soyFACE/chamberozonecontrol-Rev2/Documentation/wiring diagram/wiring diagram R1.pdf

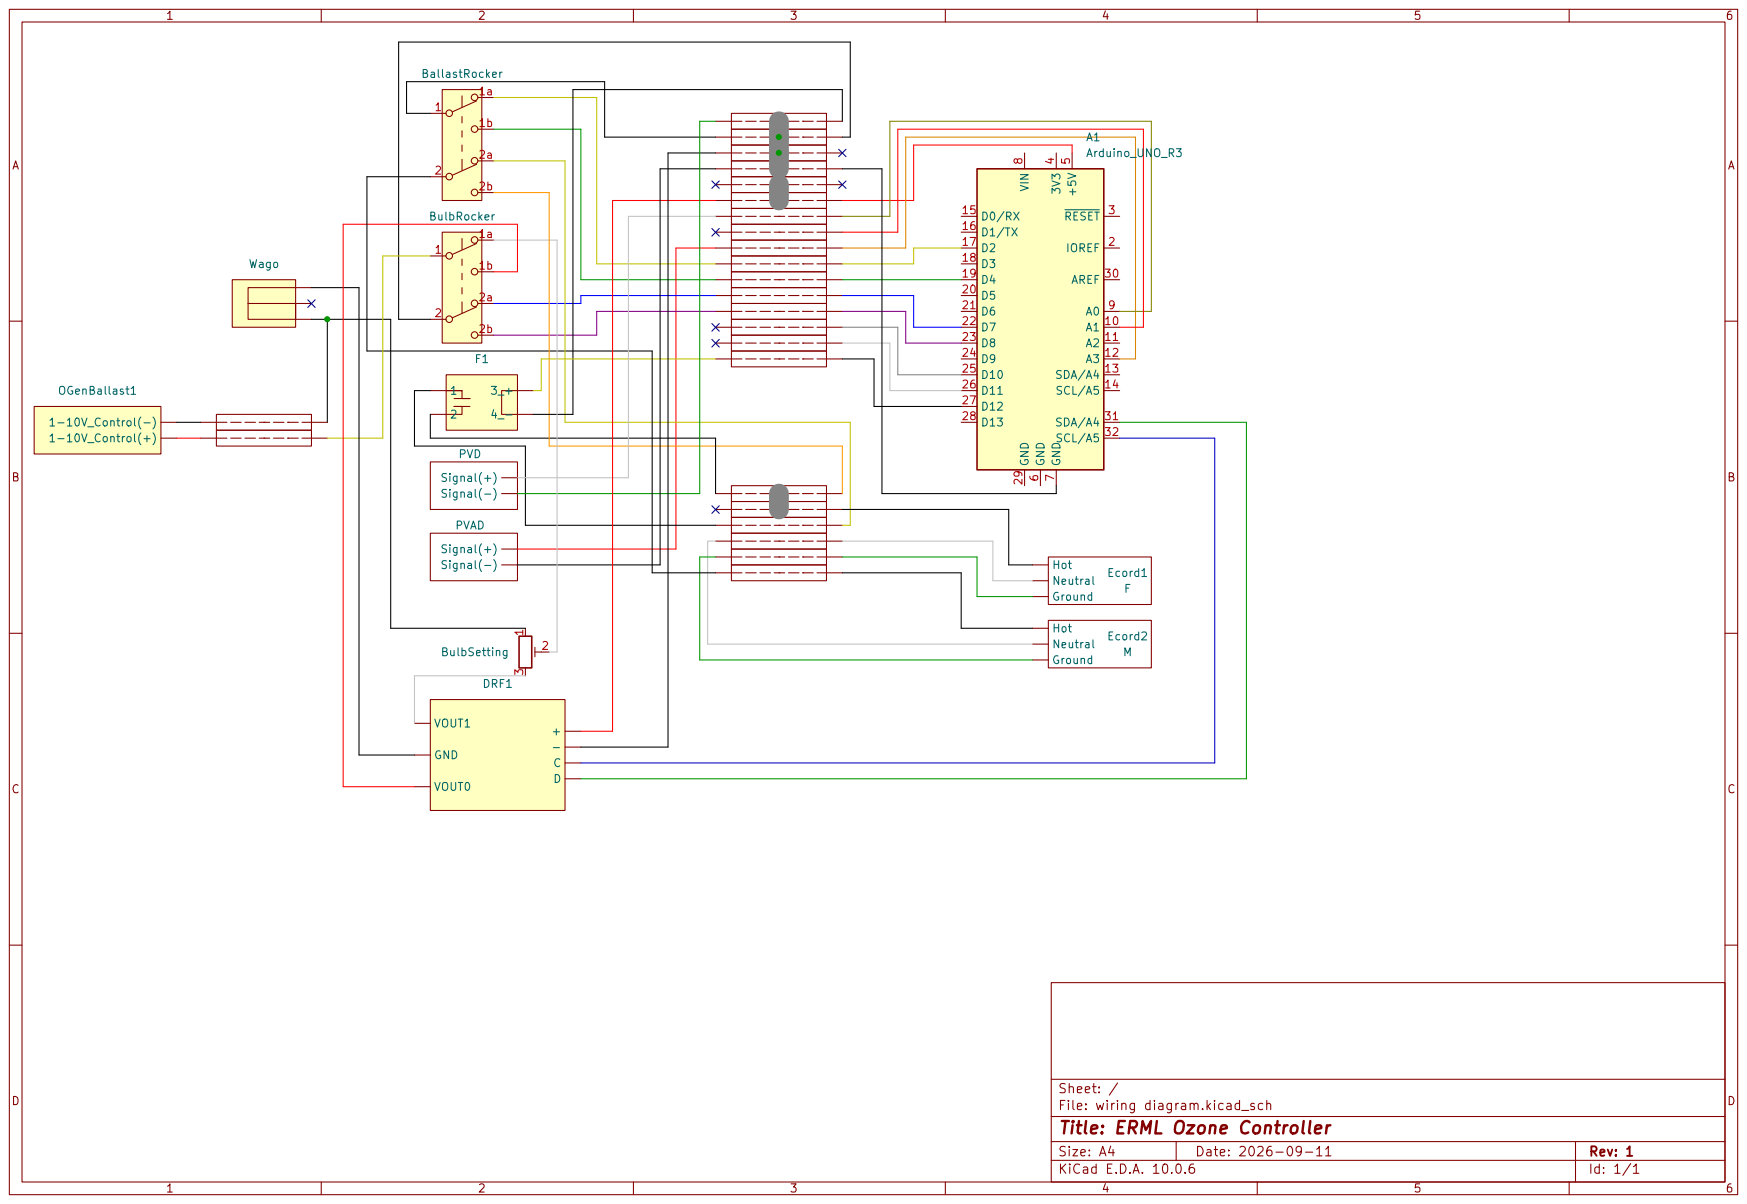
[picture p1: page 1]
