soyFACE/chamberozonecontrol-Rev2/Documentation/wiring diagram/wiring diagram.kicad_sch

## KiCad design Documentation/wiring diagram/wiring diagram.kicad_sch (2026-09-14)

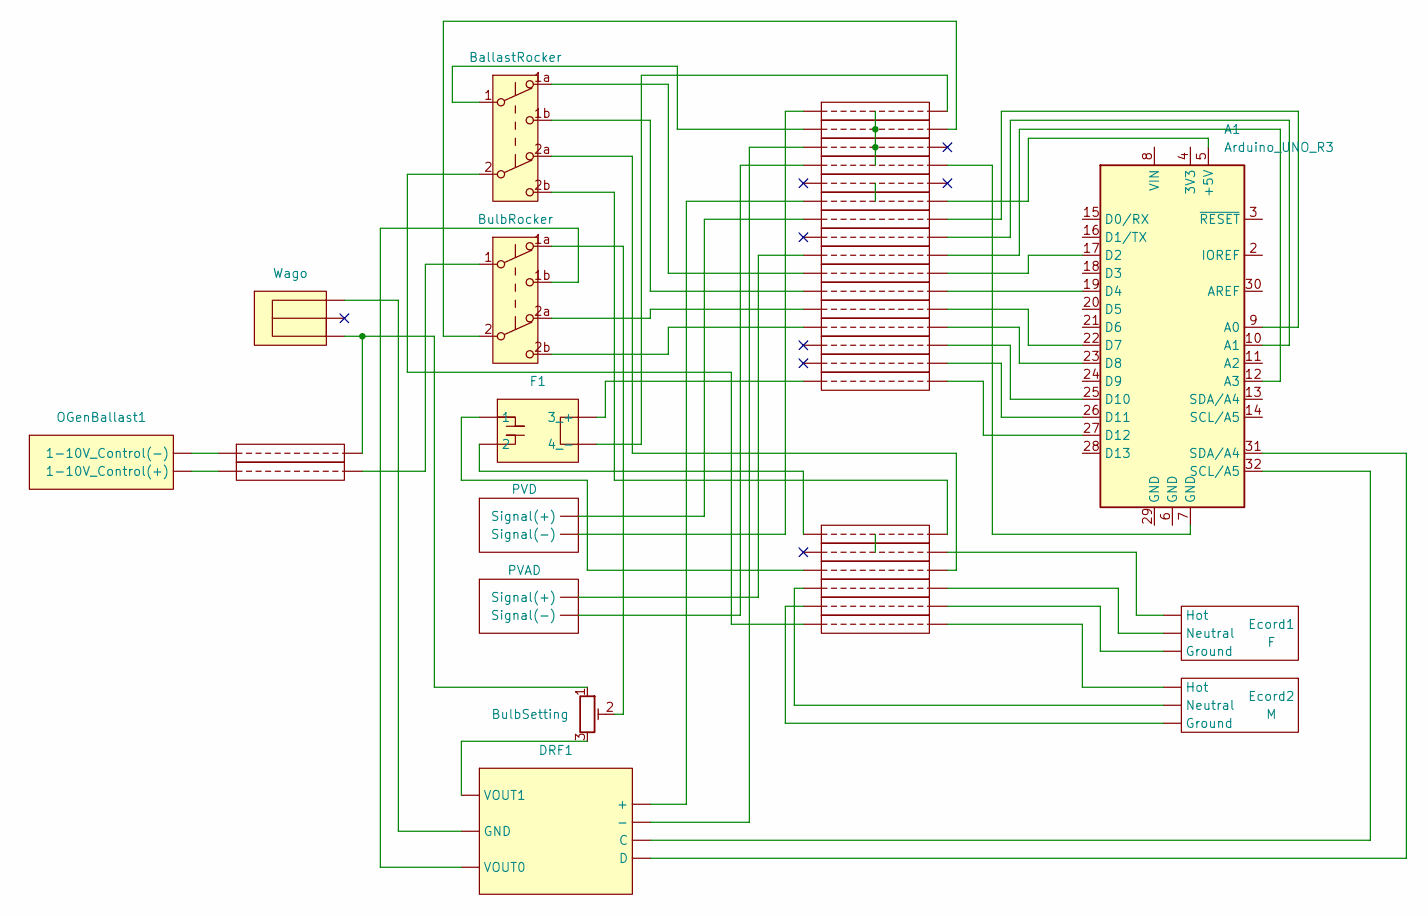
[picture p2: schematic wiring diagram.kicad_sch]

Parts:
A1: Arduino_UNO_R3
BallastRocker: SW_Push_DPDT
BulbRocker: SW_Push_DPDT
BulbSetting: R_Potentiometer_Trim
DRF1: (no value)
Ecord1: F
Ecord2: M
F1: (no value)
OGenBallast1: (no value)
PVAD: O1
PVD: O1
U1: 1
U2, U3, U4, U5, U6, U7, U8, U9, U10, U11, U12, U13, U14, U15, U16, U17, U18, U19, U20, U21, U22, U23, U24: 2
Wago: (no value)

Connections:
unnamed: A1.5 (+5V), U11.
unnamed: A1.7 (GND), U13.
unnamed: A1.9 (A0), U10.
unnamed: A1.10 (A1), U9.
unnamed: A1.12 (A3), U8.
unnamed: A1.17 (D2), U1.
unnamed: A1.19 (D4), U2.
unnamed: A1.22 (D7), U3.
unnamed: A1.23 (D8), U4.
unnamed: A1.25 (D10), U5.
unnamed: A1.26 (D11), U6.
unnamed: A1.27 (D12), U7.
unnamed: A1.31 (SDA/A4), DRF1.
unnamed: A1.32 (SCL/A5), DRF1.
unnamed: BallastRocker.1 (B), U15.
unnamed: BallastRocker.1a (A), U1.
unnamed: BallastRocker.1b (C), U2.
unnamed: BallastRocker.2 (B), U24.
unnamed: BallastRocker.2a (A), U21.
unnamed: BallastRocker.2b (C), U19.
unnamed: BulbRocker.1 (B), U18.
unnamed: BulbRocker.1a (A), BulbSetting.2
unnamed: BulbRocker.1b (C), DRF1.
unnamed: BulbRocker.2 (B), U15.
unnamed: BulbRocker.2a (A), U3.
unnamed: BulbRocker.2b (C), U4.
unnamed: BulbSetting.1, U17., Wago.
unnamed: BulbSetting.3, DRF1.
unnamed: DRF1., U11., U14., Wago.
unnamed: Ecord1., U20., U22., U23.
unnamed: Ecord2., U22., U23., U24.
unnamed: F1., U7., U16., U19., U21.
unnamed: OGenBallast1., U17., U18.
unnamed: PVAD., U8., U13.
unnamed: PVD., U10., U16.
unnamed: U11., U12.
unnamed: U13., U14., U15., U16.
unnamed: U19., U20.
