soyFACE/chamberozonecontrol-Rev2/Documentation/wiring table.xlsx

device A | device A pin | device B pin | device pin | wire color
arduino | 0
arduino | 1
arduino | 2 | ballast rocker | 1a | yellow
arduino | 3
arduino | 4 | ballast rocker | 1b | green
arduino | 5
arduino | 6
arduino | 7 | bulb rocker | 2a | blue
arduino | 8 | bulb rocker | 2b | purple
arduino | 9
arduino | 10 | none |  | grey
arduino | 11 | none |  | white
arduino | 12 | solid state relay | 3 (+) | black
arduino | 13
arduino | GND
arduino | AREF
arduino | SDA | DFR0971 | D | green
arduino | SEL | DFR0971 | C | blue
arduino | IOREF
arduino | RESET
arduino | 3.3V
arduino | 5V | DFR0971 | + | red | through 5V bus
arduino | GND | DFR0971 | - | black | Through common negative bus
arduino | GND | process value device | signal (-) | black | Through common negative bus
arduino | GND | process value alterate device | signal (-) | black | Through common negative bus
arduino | GND | ballast rocker | 1 | black | Through common negative bus
arduino | GND | bulb rocker | 2 | black | Through common negative bus
arduino | GND | solid state relay | 4 (-) | black | Through common negative bus
arduino | GND
arduino | GND
arduino | Vin
arduino | A0 | process value device | signal (+) | brown
arduino | A1 | none |  | red
arduino | A2
arduino | A3 | process value alternate device | signal (+) | orange
arduino | A4
arduino | A5
DFR0971 | GND | ozone generator ballast | 1-10V control (-) | black | through WAGO
DFR0971 | GND | bulb setting potentiometer | 1 | black | through WAGO
DFR0971 | VOUT0 | bulb rocker | 1b | red
DFR0971 | VOUT1 | bulb setting potentiometer | 3 | white
ballast rocker | 2 | extension cord male | hot 120 V | black
ballast rocker | 2b | extension cord female | hot 120 V | orange
ballast rocker | 2a | solid state relay | 1 | yellow
solid state relay | 2 | extension cord female | hot 120 V | black
solid state relay | 2 | ballast rocker | 2b | black | this is not part of how the circuit is controlled, but is here for completeness
bulb rocker | 1 | ozone generator ballast | 1-10V control (+) | yellow
bulb rocker | 1a | bulb setting potentiometer | 2 | white
extension cord male | neutral 120 V | extension cord female | neutral 120 V | white
extension cord male | ground 120 V | extension cord female | ground 120 V | green
