soyFACE/chamberozonecontrol-Rev2/(commit log)

2026-09-14 Add initial files from chamberozonecontrol
    Copied files from the chamberozonecontrol repository for the previous hardware version and removed dates from names of files
    [wiring diagram.kicad_pcb, wiring diagram.kicad_sch, wiring table.xlsx]
2026-09-14 Update ozonepidcontrol.ino
    Fixed error that incorrectly set DACout to minimum value instead of DFRout.
    Cleaned up unused code.
    [ozonepidcontrol.ino]
2026-10-01 Integrate door sensor for ozone control
    Added door sensor functionality to control ozone output based on door status.
    This is a minimum effort fix but will work as a base to integrate the other changes we planned on paper.
    [ozonepidcontrol.ino]
2026-10-01 Read door sensor state in ozone control logic
    Added door sensor state reading to the control logic.
